JaakkoKammonen/ePlant-Oppari/Mobiilisovellusvol2/ePlant/src/assets/set_image/caraway.jpg

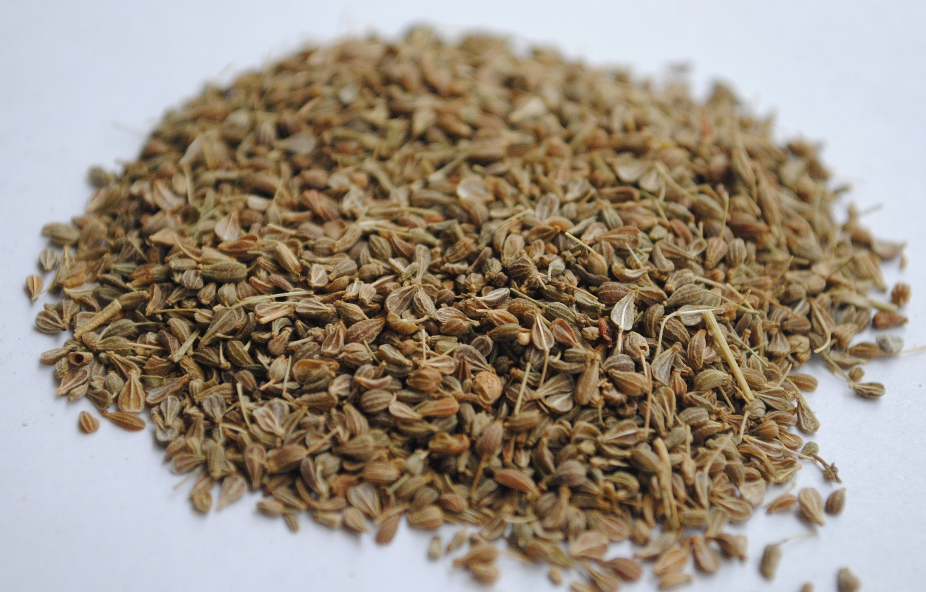
Mobiilisovellusvol2/ePlant/src/assets/set_image/caraway.jpg
