JaakkoKammonen/ePlant-Oppari/Mobiilisovellusvol2/ePlant/src/assets/set_image/parsley.jpg

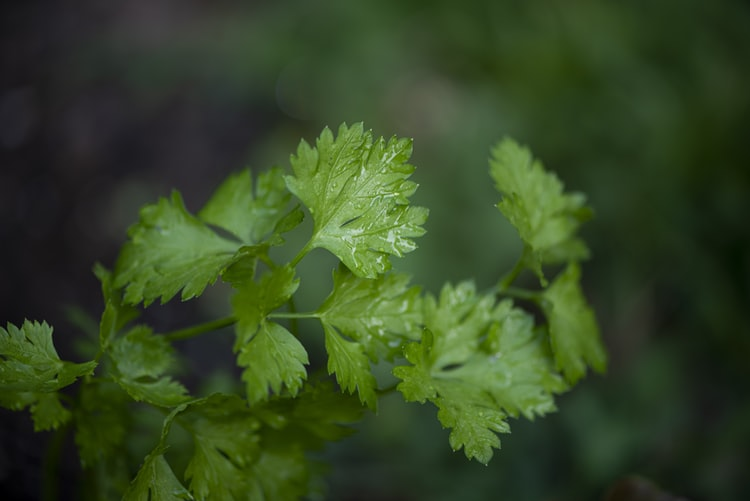
Mobiilisovellusvol2/ePlant/src/assets/set_image/parsley.jpg
