JaakkoKammonen/ePlant-Oppari/3D-tulostus/Ilmapumppu/bd96768acd2a12c32e287ad1390c2843.png

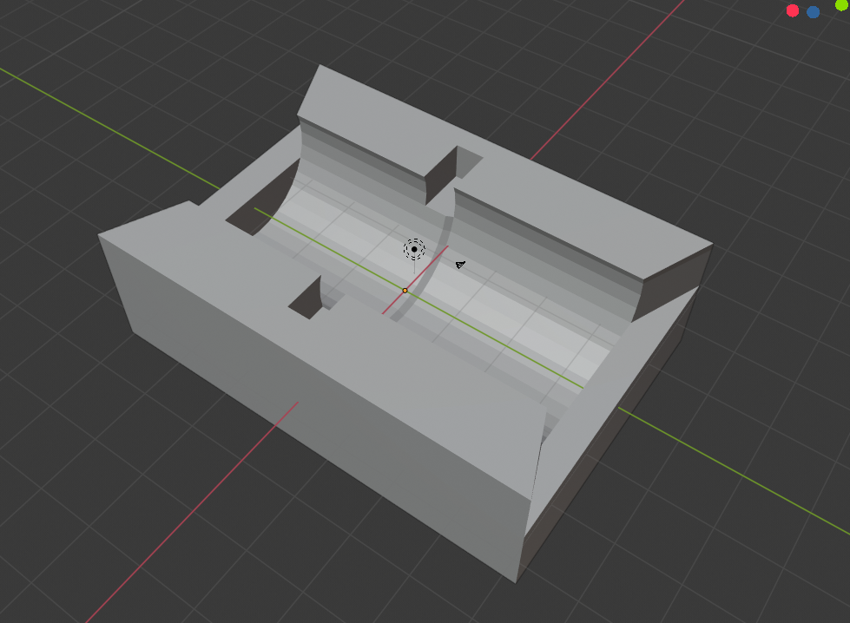
3D-tulostus/Ilmapumppu/bd96768acd2a12c32e287ad1390c2843.png
