JaakkoKammonen/ePlant-Oppari/3D-tulostus/Ilmapumppu/ilmapumppu.png

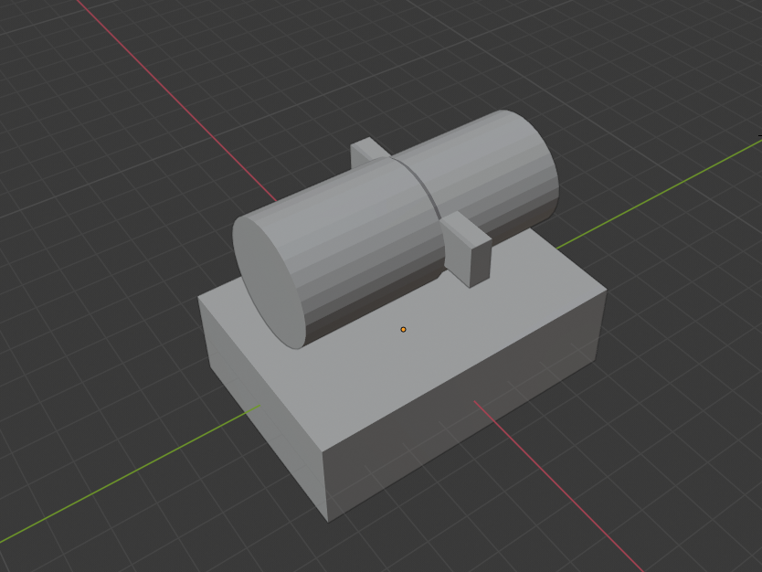
3D-tulostus/Ilmapumppu/ilmapumppu.png
