JaakkoKammonen/ePlant-Oppari/Mobiilisovellusvol2/ePlant/src/assets/done_pot.png

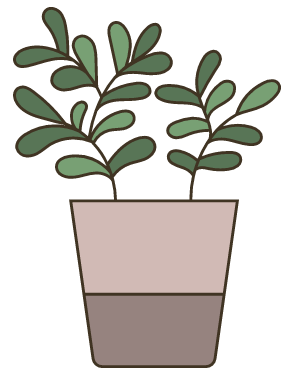
Mobiilisovellusvol2/ePlant/src/assets/done_pot.png
