JaakkoKammonen/ePlant-Oppari/Mobiilisovellusvol2/ePlant/src/assets/eP.png

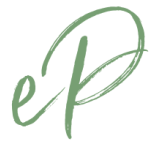
Mobiilisovellusvol2/ePlant/src/assets/eP.png
