JaakkoKammonen/ePlant-Oppari/Mobiilisovellusvol2/ePlant/src/assets/help.png

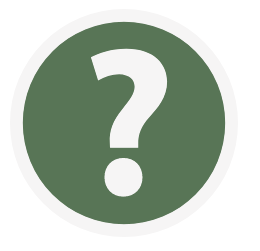
Mobiilisovellusvol2/ePlant/src/assets/help.png
