JaakkoKammonen/ePlant-Oppari/Mobiilisovellusvol2/ePlant/src/assets/hydro.png

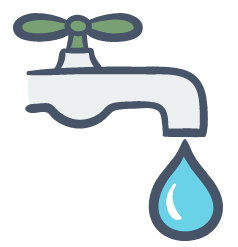
Mobiilisovellusvol2/ePlant/src/assets/hydro.png
