JaakkoKammonen/ePlant-Oppari/Mobiilisovellusvol2/ePlant/src/assets/info.png

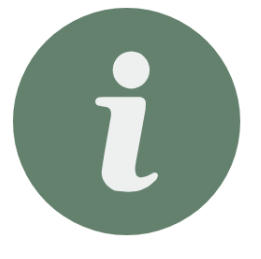
Mobiilisovellusvol2/ePlant/src/assets/info.png
