JaakkoKammonen/ePlant-Oppari/Mobiilisovellusvol2/ePlant/src/assets/information.png

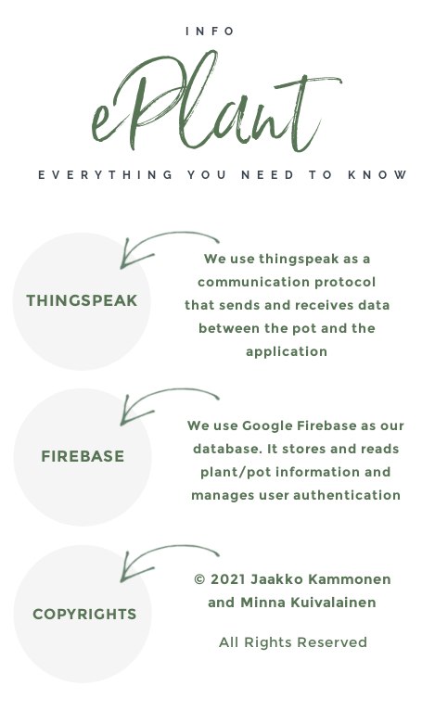
Mobiilisovellusvol2/ePlant/src/assets/information.png
