JaakkoKammonen/ePlant-Oppari/Mobiilisovellusvol2/ePlant/src/assets/oops2.png

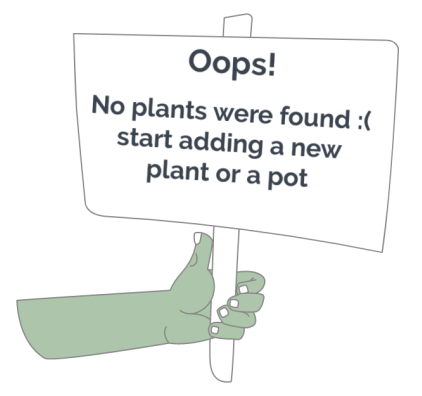
Mobiilisovellusvol2/ePlant/src/assets/oops2.png
