JaakkoKammonen/ePlant-Oppari/Mobiilisovellusvol2/ePlant/src/assets/safety1.png

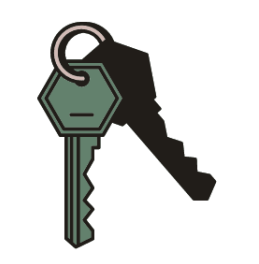
Mobiilisovellusvol2/ePlant/src/assets/safety1.png
