JaakkoKammonen/ePlant-Oppari/Mobiilisovellusvol2/ePlant/src/assets/safety.png

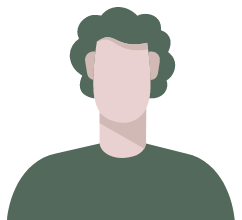
Mobiilisovellusvol2/ePlant/src/assets/safety.png
