JaakkoKammonen/ePlant-Oppari/Mobiilisovellusvol2/ePlant/src/assets/selectplant.png

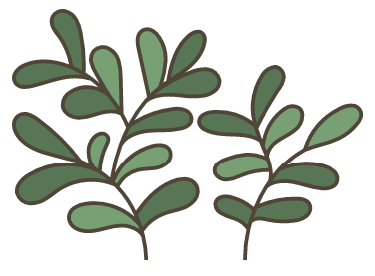
Mobiilisovellusvol2/ePlant/src/assets/selectplant.png
