JaakkoKammonen/ePlant-Oppari/Mobiilisovellusvol2/ePlant/src/assets/selectpot.png

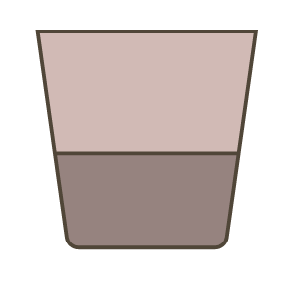
Mobiilisovellusvol2/ePlant/src/assets/selectpot.png
