JaakkoKammonen/ePlant-Oppari/Mobiilisovellusvol2/ePlant/src/assets/set_image/basil.jpg

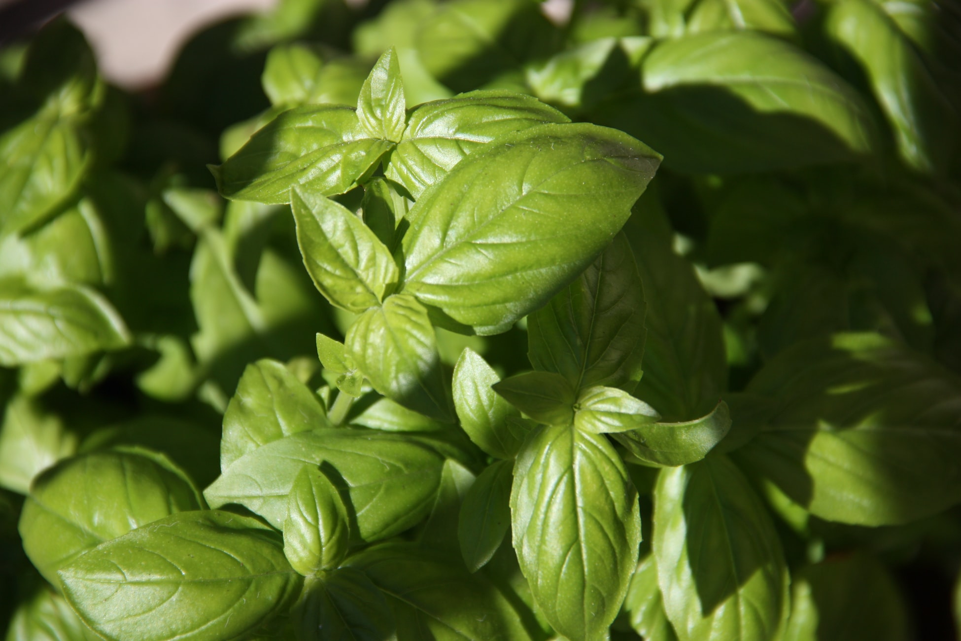
Mobiilisovellusvol2/ePlant/src/assets/set_image/basil.jpg
