JaakkoKammonen/ePlant-Oppari/Mobiilisovellusvol2/ePlant/src/assets/set_image/chive.jpg

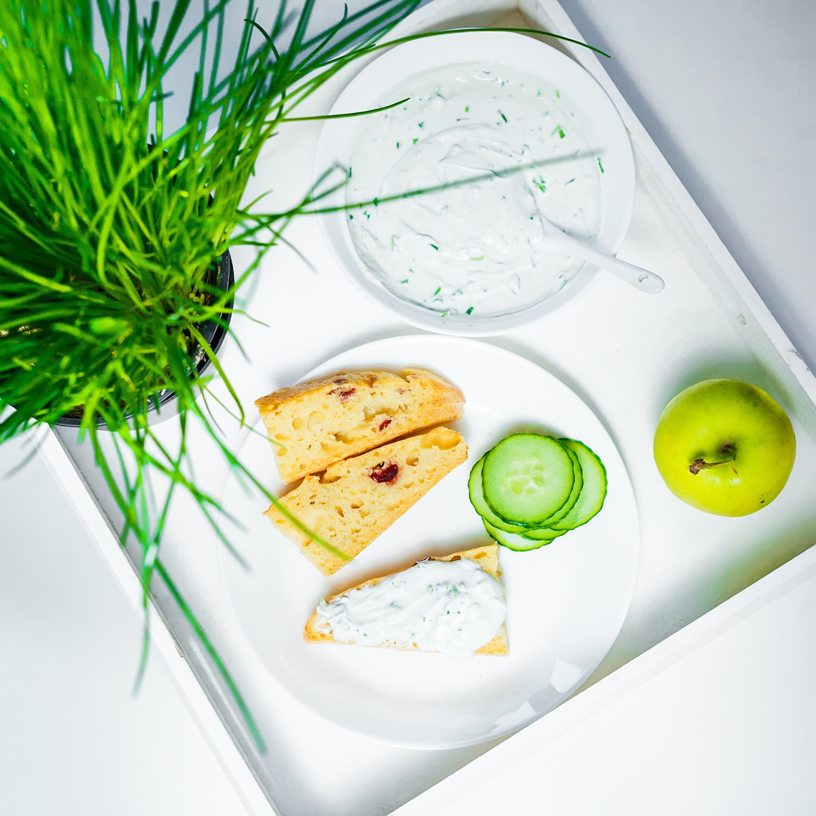
Mobiilisovellusvol2/ePlant/src/assets/set_image/chive.jpg
