JaakkoKammonen/ePlant-Oppari/Mobiilisovellusvol2/ePlant/src/assets/set_image/dill.jpg

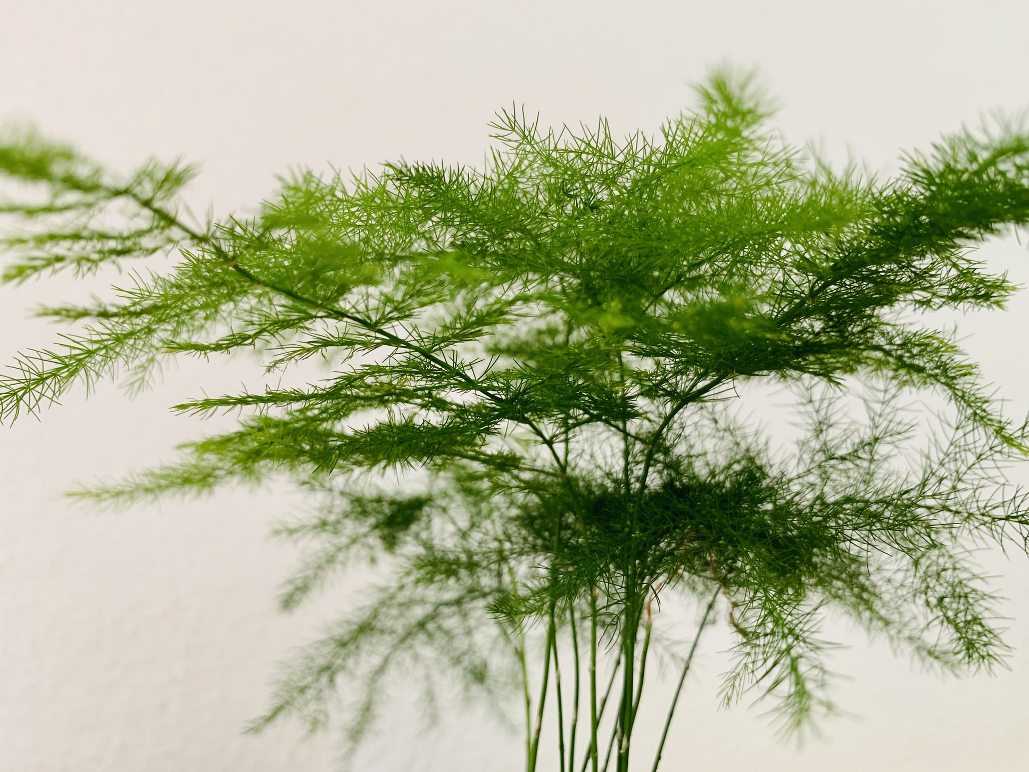
Mobiilisovellusvol2/ePlant/src/assets/set_image/dill.jpg
