JaakkoKammonen/ePlant-Oppari/Mobiilisovellusvol2/ePlant/src/assets/set_image/lemon_balm.jpg

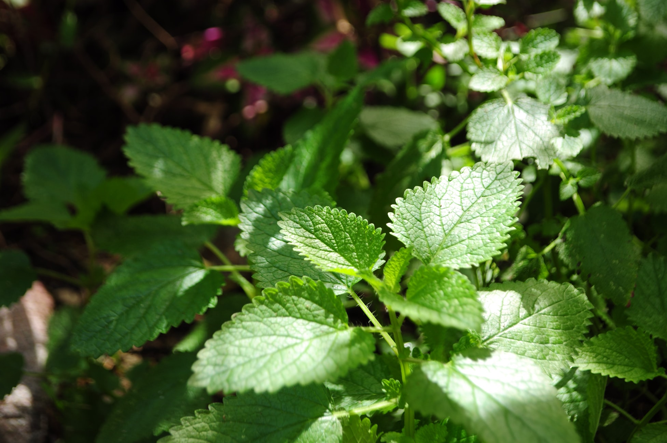
Mobiilisovellusvol2/ePlant/src/assets/set_image/lemon_balm.jpg
