JaakkoKammonen/ePlant-Oppari/Mobiilisovellusvol2/ePlant/src/assets/set_image/mint.jpg

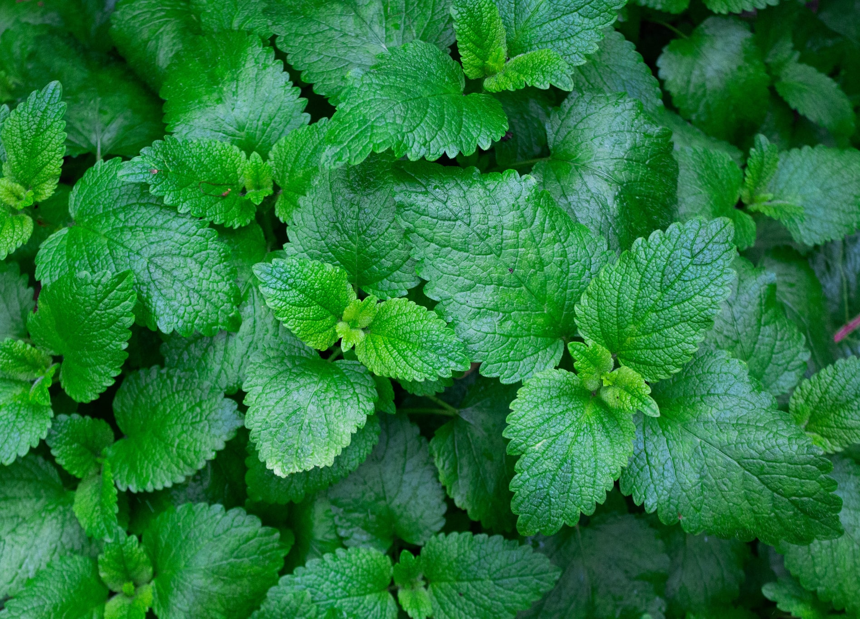
Mobiilisovellusvol2/ePlant/src/assets/set_image/mint.jpg
