JaakkoKammonen/ePlant-Oppari/Mobiilisovellusvol2/ePlant/src/assets/set_image/oregano.jpg

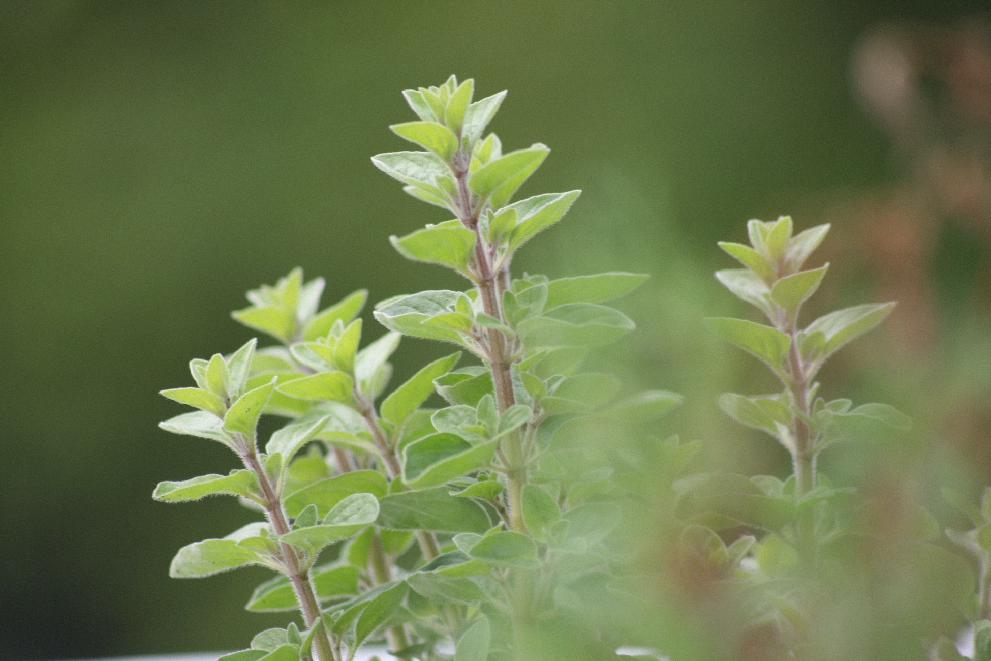
Mobiilisovellusvol2/ePlant/src/assets/set_image/oregano.jpg
