JaakkoKammonen/ePlant-Oppari/Mobiilisovellusvol2/ePlant/src/assets/set_image/other.jpg

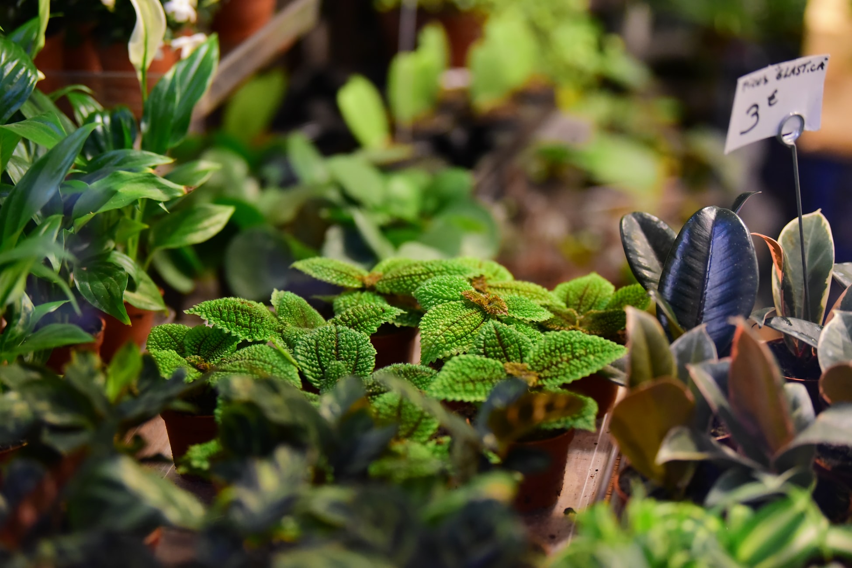
Mobiilisovellusvol2/ePlant/src/assets/set_image/other.jpg
