JaakkoKammonen/ePlant-Oppari/Mobiilisovellusvol2/ePlant/src/assets/set_image/thyme.jpg

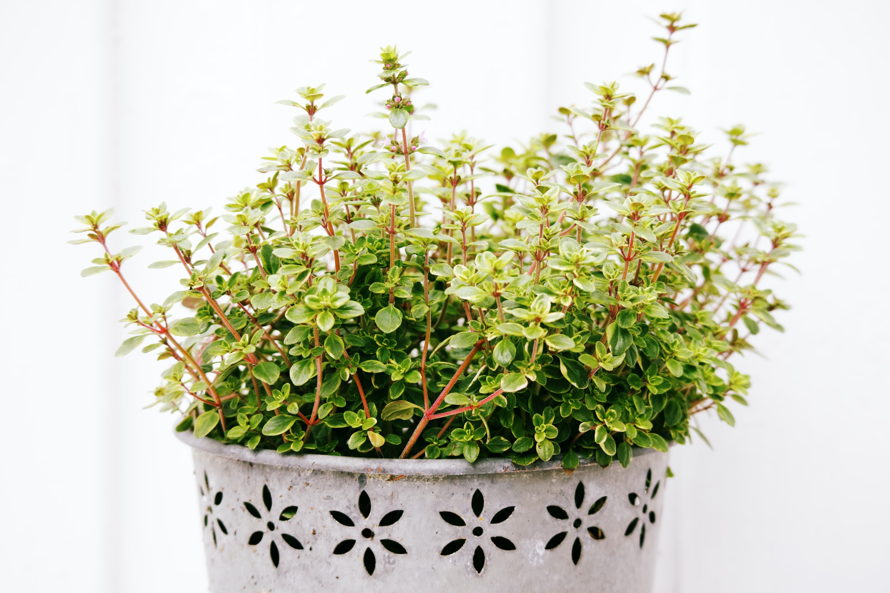
Mobiilisovellusvol2/ePlant/src/assets/set_image/thyme.jpg
