JaakkoKammonen/ePlant-Oppari/Mobiilisovellusvol2/ePlant/src/assets/soil.png

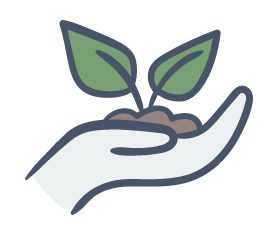
Mobiilisovellusvol2/ePlant/src/assets/soil.png
