JaakkoKammonen/ePlant-Oppari/Mobiilisovellusvol2/ePlant/src/assets/thingspeak.png

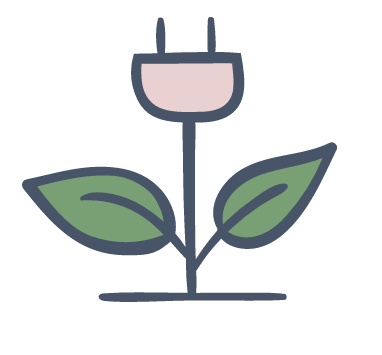
Mobiilisovellusvol2/ePlant/src/assets/thingspeak.png
