JaakkoKammonen/ePlant-Oppari/3D-tulostus/Ilmapumppu/ilmapumppu-Cube.stl

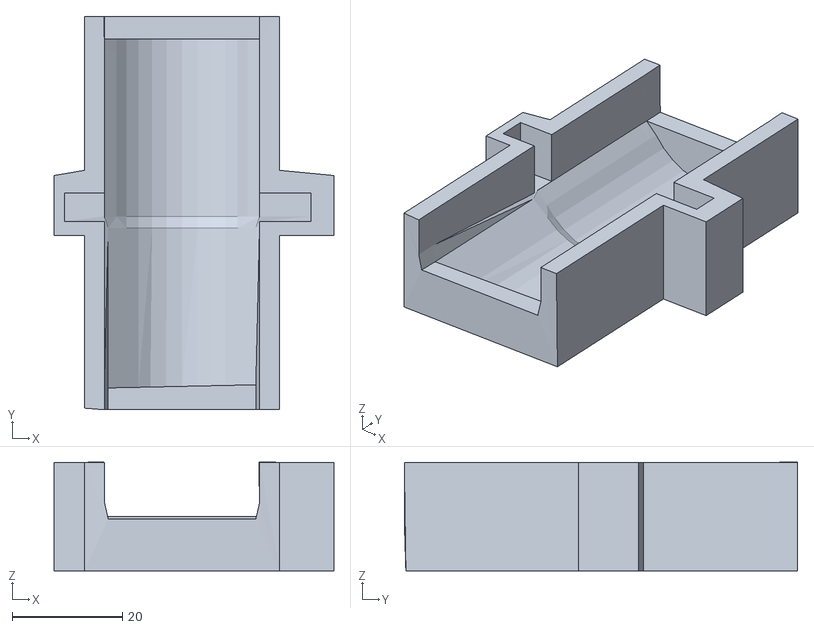
[picture p86: CAD file, 2021-04-01]
3D-tulostus/Ilmapumppu/ilmapumppu-Cube.stl
50.8 x 71.3 x 19.7
