JaakkoKammonen/ePlant-Oppari/3D-tulostus/netcup-50mm-stackable.stl

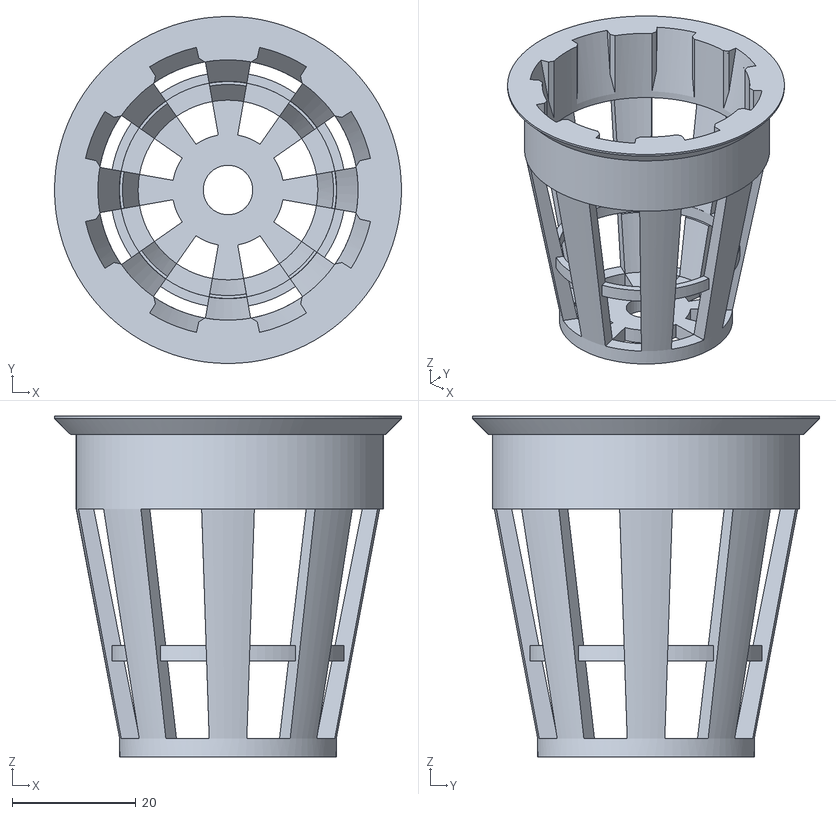
[picture p87: CAD file, 2021-03-26]
3D-tulostus/netcup-50mm-stackable.stl
56.0 x 56.0 x 55.0
