JaakkoKammonen/ePlant-Oppari/3D-tulostus/PH-mittari/PH-Circle.stl

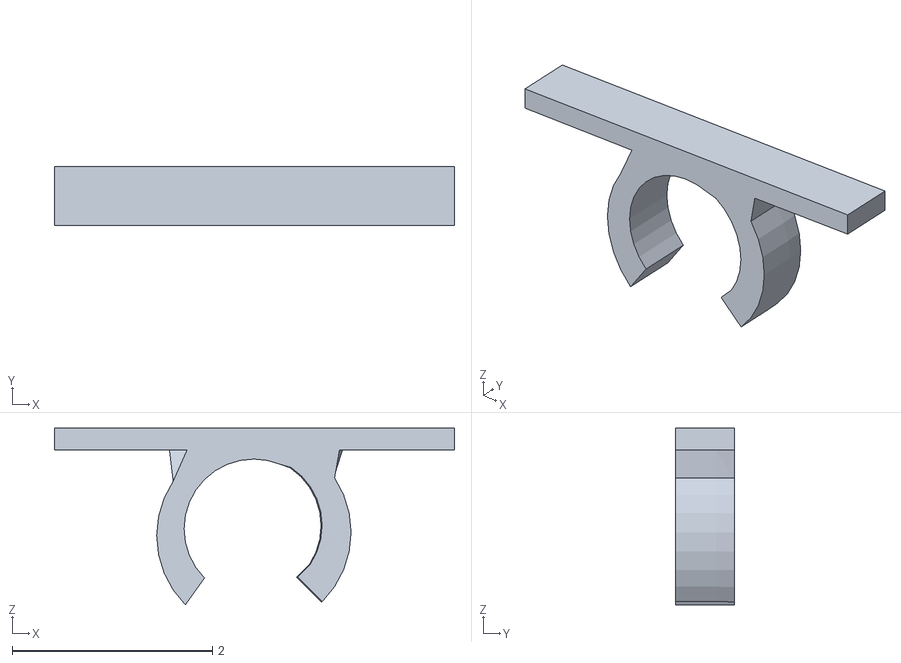
[picture p88: CAD file, 2021-04-01]
3D-tulostus/PH-mittari/PH-Circle.stl
4.00 x 0.592 x 1.77
