JaakkoKammonen/ePlant-Oppari/3D-tulostus/PH-piirikortti/phpiirikortti-Cube.stl

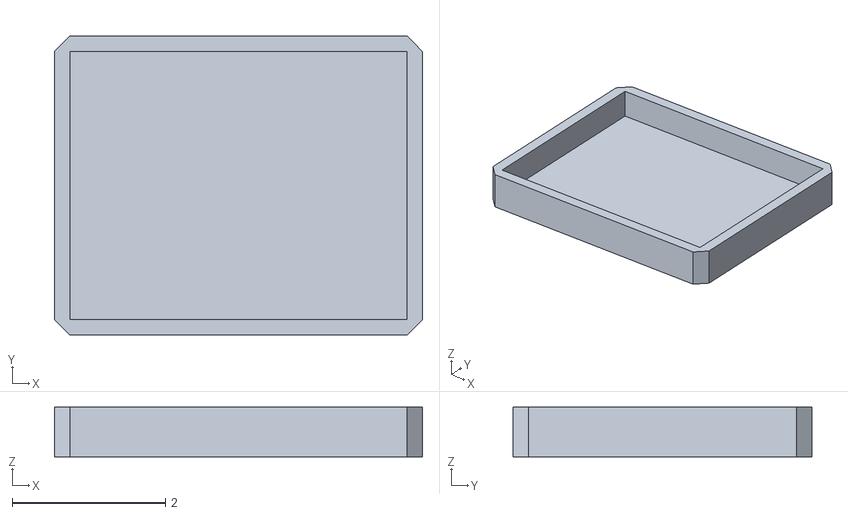
[picture p89: CAD file, 2021-04-01]
3D-tulostus/PH-piirikortti/phpiirikortti-Cube.stl
4.80 x 3.90 x 0.652
