JaakkoKammonen/ePlant-Oppari/3D-tulostus/Valmiit printattavat/kansi-Kansi.stl

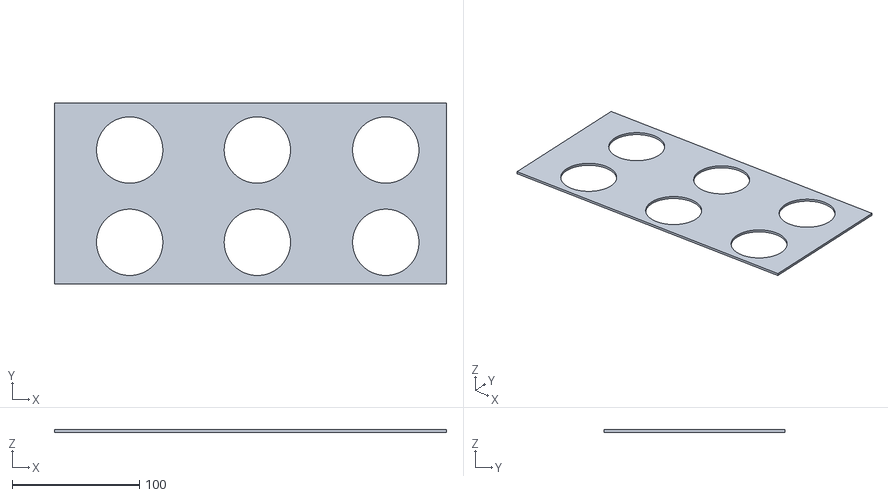
[picture p90: CAD file, 2021-04-26]
3D-tulostus/Valmiit printattavat/kansi-Kansi.stl
307.8 x 142.2 x 2.12
