JaakkoKammonen/ePlant-Oppari/3D-tulostus/Valmiit printattavat/Ruukku.stl

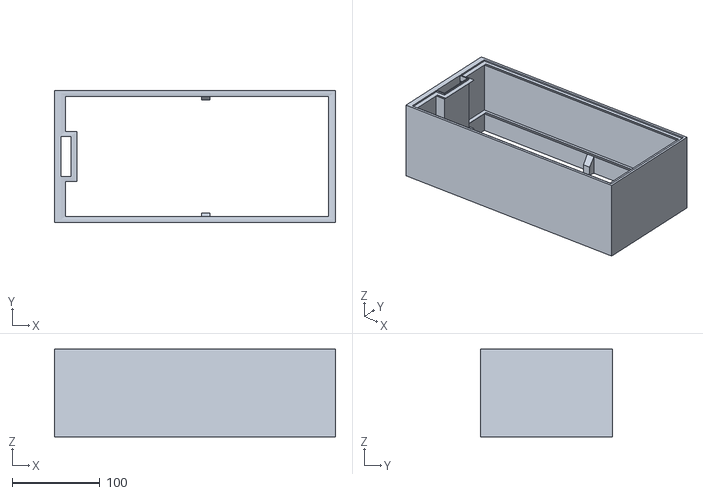
[picture p91: CAD file, 2021-04-20]
3D-tulostus/Valmiit printattavat/Ruukku.stl
320.0 x 150.0 x 100.0
