JaakkoKammonen/ePlant-Oppari/3D-tulostus/Valmiit printattavat/vesipohja.stl

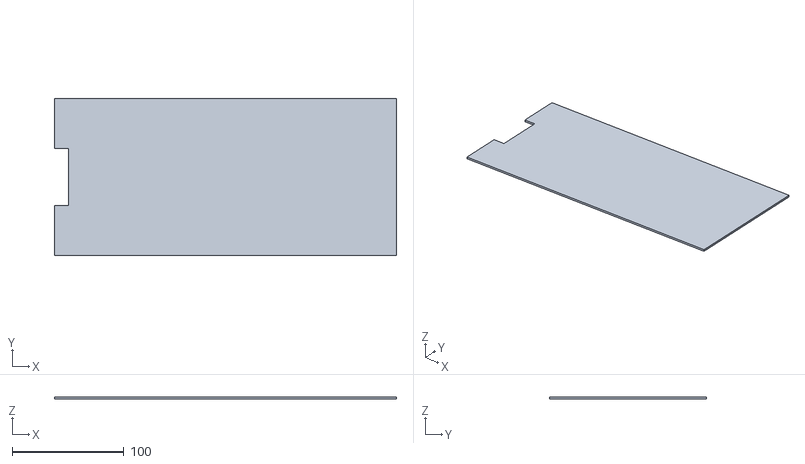
[picture p92: CAD file, 2021-04-20]
3D-tulostus/Valmiit printattavat/vesipohja.stl
306.7 x 140.8 x 2.00
