JaakkoKammonen/ePlant-Oppari/3D-tulostus/Valmiit printattavat/Ruukun pohja.stl

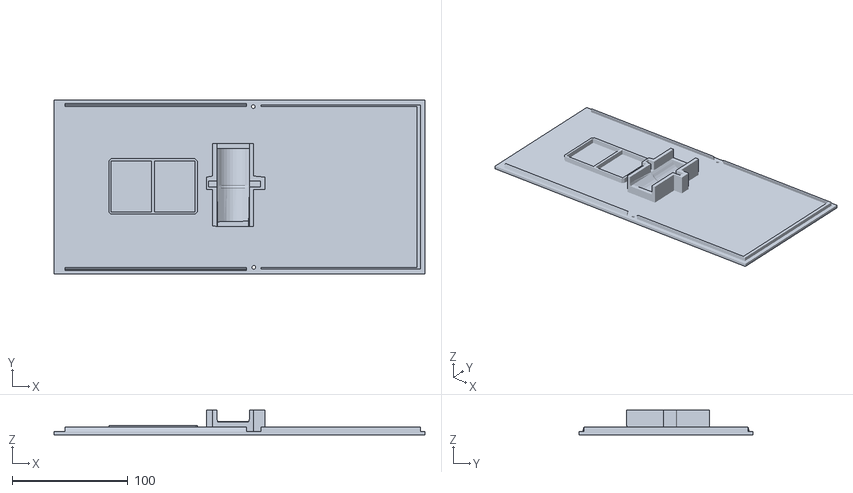
[picture p93: CAD file, 2021-04-20]
3D-tulostus/Valmiit printattavat/Ruukun pohja.stl
320.0 x 150.0 x 21.5
