JaakkoKammonen/ePlant-Oppari/(list of files, cad)

Other CAD files:
3D-tulostus/Valmiit printattavat/NetCup.stl
3D-tulostus/Ilmapumppu/ilmapumppu.blend
3D-tulostus/NFT-system (2).blend
3D-tulostus/PH-mittari/PH.blend
3D-tulostus/PH-piirikortti/phpiirikortti.blend
3D-tulostus/kansi.blend
