JaakkoKammonen/ePlant-Oppari/Mobiilisovellusvol2/ePlant/src/assets/pot_test.png

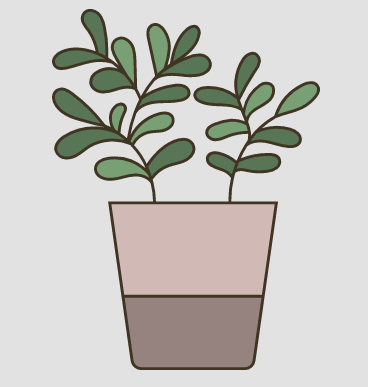
Mobiilisovellusvol2/ePlant/src/assets/pot_test.png
