JaakkoKammonen/ePlant-Oppari/(commit log)

2021-03-26 esp32 koodin vaihtoa. Kesken vähän
2021-04-01 3d malentamista
    [NFT-system.blend, PH-Circle.stl, PH.blend, ilmapumppu-Cube.stl, ilmapumppu-Cube_fixed.stl, ilmapumppu.blend, phpiirikortti-Cube.stl, phpiirikortti.blend]
2021-04-06 Päivitys
    [NFT-system-Cube.stl, NFT-system-Cube_fixed.stl, NFT-system-Pohja.stl, NFT-system.blend]
2021-04-20 Kasvien päivitystä + Arduino
2021-05-26 Airpump on/off ja sensori datan lähetys
2021-05-26 sensoridatan lähetys valinta poistettu
2021-05-28 sensorit toimii
2021-05-31 Potsien buttonit fiksattu
